somiandras/midi-merger/README.md

# Midi Merge Box

My embedded 🦀 Rust learning project: 2 in, 5 out MIDI merge box based
on a Raspberry Pico board.
