somiandras/midi-merger/hardware/hestore_shopping_list.txt

100.298.79	2	6N138 optocoupler (U1,U2)
100.215.82	1	74HCT14 DIP-14 (U3)
100.230.64	2	1N4148 DO-35 (D1,D2)
100.423.05	7	PJ-3136-B 3.5mm jack (J1,J2,J5-J9)
100.241.52	2	ZL305-20SG 1x20 socket 2.54mm for Pico (J3,J4)
100.231.32	2	DIL08 IC socket (U1,U2)
100.231.33	1	DIL14 IC socket (U3)
100.240.31	14	220R 1% 0.4W metal film (R1,R2,R5,R6,R11-R20)
100.243.86	2	1K 1% 0.4W metal film (R7,R8)
100.243.92	2	2K 1% 0.4W metal film (R9,R10)
100.244.02	2	5.1K 1% 0.4W metal film (R3,R4)
100.234.72	3	100nF 50V X7R RM2.5 (C1,C2,C3)
100.251.22	1	10uF 50V electrolytic 5x11 RM2 (C4)
