somiandras/midi-merger/hardware/MIDI Box.csv

# | Reference | Qty | Value | Footprint | DNP
1 | C1, C2, C3 | 3 | 0.1uF | Capacitor_THT:C_Disc_D3.4mm_W2.1mm_P2.50mm
2 | C4 | 1 | 10uF | Capacitor_THT:CP_Radial_D5.0mm_P2.00mm
3 | D1, D2 | 2 | 1N4148 | Diode_THT:D_T-1_P5.08mm_Horizontal
4 | J1 | 1 | MIDI_IN_1 | own_components:Audio Jack PJ-3136-B
5 | J2 | 1 | MIDI_IN_2 | own_components:Audio Jack PJ-3136-B
6 | J3, J4 | 2 | Conn_01x20_Socket | Connector_PinSocket_2.54mm:PinSocket_1x20_P2.54mm_Vertical
7 | J5 | 1 | MIDI_OUT_1 | own_components:Audio Jack PJ-3136-B
8 | J6 | 1 | MIDI_OUT_2 | own_components:Audio Jack PJ-3136-B
9 | J7 | 1 | MIDI_OUT_3 | own_components:Audio Jack PJ-3136-B
10 | J8 | 1 | MIDI_OUT_4 | own_components:Audio Jack PJ-3136-B
11 | J9 | 1 | MIDI_OUT_5 | own_components:Audio Jack PJ-3136-B
12 | R1, R2, R5, R6, R11, R12, R13, R14, R15, R16, R17, R18, R19, R20 | 14 | 220 | Resistor_THT:R_Axial_DIN0204_L3.6mm_D1.6mm_P5.08mm_Horizontal
13 | R3, R4 | 2 | 5.1K | Resistor_THT:R_Axial_DIN0204_L3.6mm_D1.6mm_P5.08mm_Horizontal
14 | R7, R8 | 2 | 1k | Resistor_THT:R_Axial_DIN0204_L3.6mm_D1.6mm_P5.08mm_Horizontal
15 | R9, R10 | 2 | 2k | Resistor_THT:R_Axial_DIN0204_L3.6mm_D1.6mm_P5.08mm_Horizontal
16 | U1, U2 | 2 | 6N138 | Package_DIP:DIP-8_W7.62mm_Socket
17 | U3 | 1 | 74HCT14 | Package_DIP:DIP-14_W7.62mm_Socket
