somiandras/midi-merger/hardware/MIDI Box.kicad_pcb

## KiCad design hardware/MIDI Box.kicad_pcb (2026-11-06)

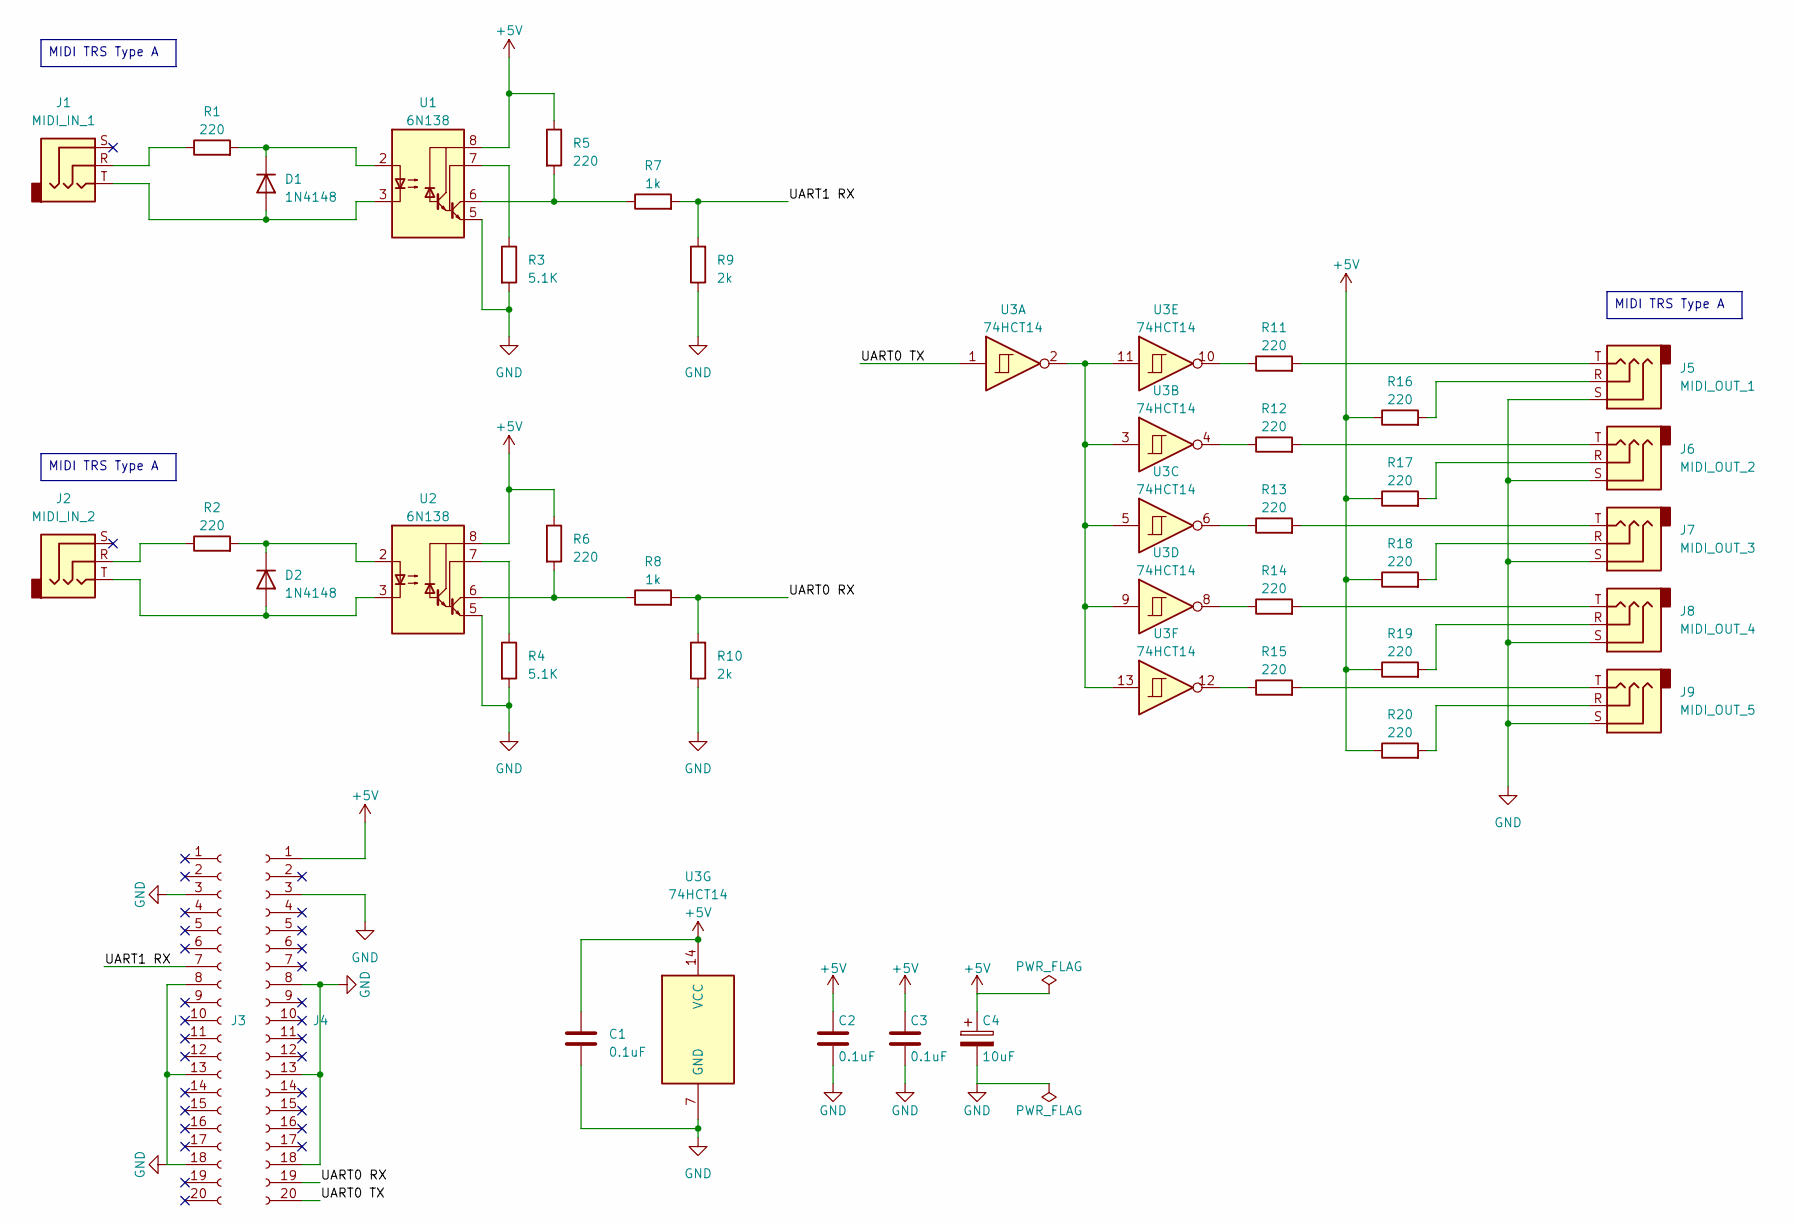
[picture p1: schematic MIDI Box.kicad_sch, Midi Merge Box]

Parts:
C1, C2, C3: 0.1uF; C_Disc_D3.4mm_W2.1mm_P2.50mm
C4: 10uF; CP_Radial_D5.0mm_P2.00mm
D1, D2: 1N4148; D_T-1_P5.08mm_Horizontal
J1: MIDI_IN_1; Audio Jack PJ-3136-B
J2: MIDI_IN_2; Audio Jack PJ-3136-B
J3, J4: Conn_01x20_Socket; PinSocket_1x20_P2.54mm_Vertical
J5: MIDI_OUT_1; Audio Jack PJ-3136-B
J6: MIDI_OUT_2; Audio Jack PJ-3136-B
J7: MIDI_OUT_3; Audio Jack PJ-3136-B
J8: MIDI_OUT_4; Audio Jack PJ-3136-B
J9: MIDI_OUT_5; Audio Jack PJ-3136-B
R1, R2, R5, R6, R11, R12, R13, R14, R15, R16, R17, R18, R19, R20: 220; R_Axial_DIN0204_L3.6mm_D1.6mm_P5.08mm_Horizontal
R3, R4: 5.1K; R_Axial_DIN0204_L3.6mm_D1.6mm_P5.08mm_Horizontal
R7, R8: 1k; R_Axial_DIN0204_L3.6mm_D1.6mm_P5.08mm_Horizontal
R9, R10: 2k; R_Axial_DIN0204_L3.6mm_D1.6mm_P5.08mm_Horizontal
U1, U2: 6N138; DIP-8_W7.62mm_Socket
U3: 74HCT14; DIP-14_W7.62mm_Socket

Connections:
+5V: C1.1, C2.1, C3.1, C4.1, J4.1, R5.1, R6.1, R16.1, R17.1, R18.1, R19.1, R20.1, U1.8 (VCC), U2.8 (VCC), U3.14 (VCC)
/UART0 RX: J4.19, R8.2, R10.2
/UART0 TX: J4.20, U3.1
/UART1 RX: J3.7, R7.2, R9.2
GND: C1.2, C2.2, C3.2, C4.2, J3.3, J3.8, J3.13, J3.18, J4.3, J4.8, J4.13, J4.18, J5.S, J6.S, J7.S, J8.S, J9.S, R3.2, R4.2, R9.1, R10.1, U1.5 (GND), U2.5 (GND), U3.7 (GND)
unnamed: D1.2 (A), J1.T, U1.3 (C2)
unnamed: D1.1 (K), R1.2, U1.2 (C1)
unnamed: D2.2 (A), J2.T, U2.3 (C2)
unnamed: D2.1 (K), R2.2, U2.2 (C1)
unnamed: J1.R, R1.1
unnamed: J2.R, R2.1
unnamed: J5.R, R16.2
unnamed: J5.T, R11.2
unnamed: J6.R, R17.2
unnamed: J6.T, R12.2
unnamed: J7.R, R18.2
unnamed: J7.T, R13.2
unnamed: J8.R, R19.2
unnamed: J8.T, R14.2
unnamed: J9.R, R20.2
unnamed: J9.T, R15.2
unnamed: R11.1, U3.10
unnamed: R12.1, U3.4
unnamed: R13.1, U3.6
unnamed: R14.1, U3.8
unnamed: R15.1, U3.12
unnamed: R3.1, U1.7 (VO1)
unnamed: R5.2, R7.1, U1.6 (VO2)
unnamed: R4.1, U2.7 (VO1)
unnamed: R6.2, R8.1, U2.6 (VO2)
unnamed: U3.2, U3.3, U3.5, U3.9, U3.11, U3.13

Notes on the sheet:
MIDI TRS Type A

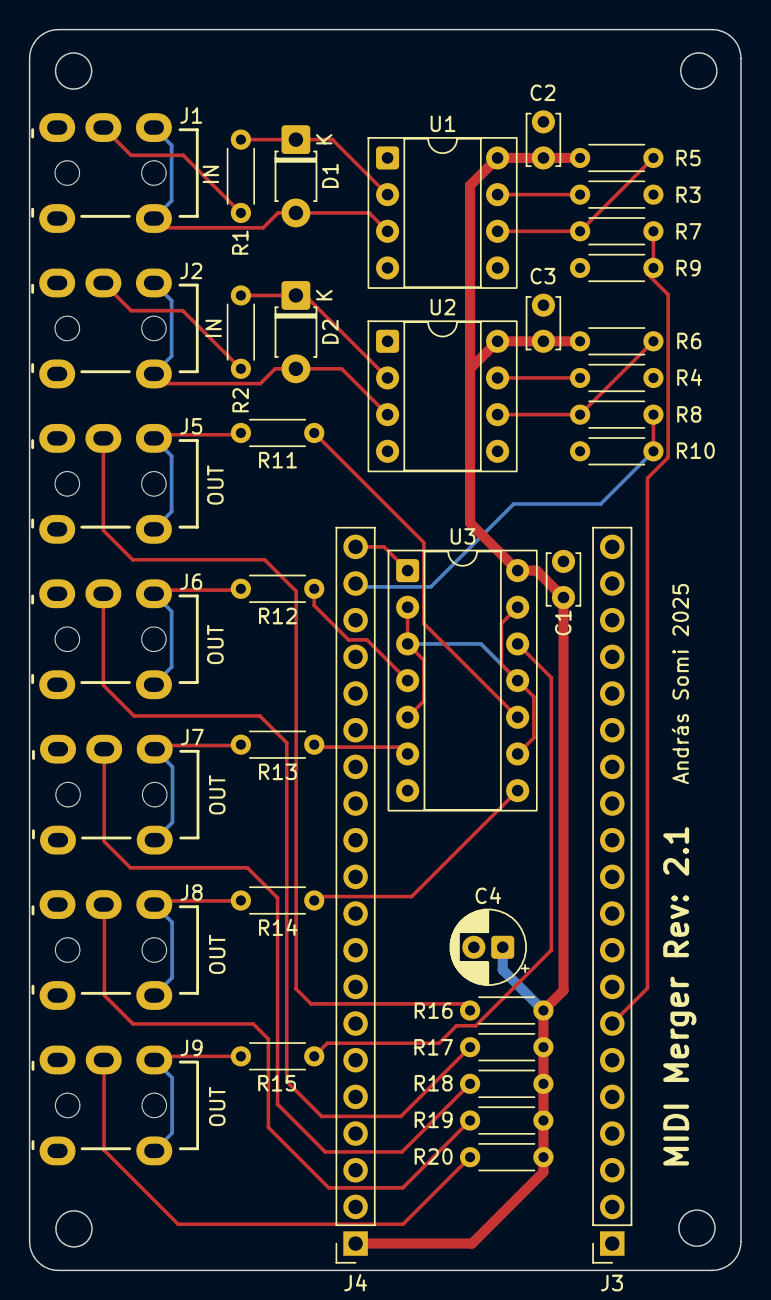
[picture p2: board MIDI Box.kicad_pcb from above]

Board: 2 copper layers, 49.3 x 85.9 mm, 38 parts (0 on the bottom side), 31 nets.
