somiandras/midi-merger/(commit log)

2025-01-06 fix uart pin
2025-01-06 add midi uart srtuct
2025-01-06 add uart write
2025-01-06 add hardware related files
    [MIDI Box-B_Cu.gbl, MIDI Box-B_Mask.gbs, MIDI Box-B_Paste.gbp, MIDI Box-B_Silkscreen.gbo, MIDI Box-Edge_Cuts.gm1, MIDI Box-F_Cu.gtl, MIDI Box-F_Mask.gts, MIDI Box-F_Paste.gtp]
2025-01-12 remove fab related artifacts
    [MIDI Box-B_Cu.gbl, MIDI Box-B_Mask.gbs, MIDI Box-B_Paste.gbp, MIDI Box-B_Silkscreen.gbo, MIDI Box-Edge_Cuts.gm1, MIDI Box-F_Cu.gtl, MIDI Box-F_Mask.gts, MIDI Box-F_Paste.gtp]
2025-02-13 v2.0 board with TRS sockets
    [MIDI Box.kicad_pcb, MIDI Box.kicad_sch]
2025-02-16 fix running status errors
    [main.rs, midi_parser.rs, midi_uart.rs]
2025-10-02 fix: replace unwrap() with proper error handling in write path
    Eliminates all panic risks in the UART write task by replacing unwrap()
    calls with explicit error handling. UART write failures now log errors
    and skip the problematic message instead of crashing the system.
    Changes:
    - Voice messages: handle write errors gracefully
    - System messages: handle write errors gracefully
    - Running status: comprehensive rewrite with proper error handling
    - Handles first-message edge case (last_tx_from = None)
    - Eliminates double unwrap() on status byte retrieval
    - Detects protocol violations (running status without prior voice)
    - Uses continue to prevent state corruption on failures
    All error p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
    [main.rs]
2025-10-02 feat: add graceful SysEx handling and fix defmt formatting
    Add System Exclusive (SysEx) message handling to MIDI parser. SysEx
    messages (0xF0...0xF7) are now silently ignored and don't corrupt
    parser state, making them transparent to the merge operation.
    Changes to midi_parser.rs:
    - Add in_sysex boolean field to MidiParser
    - Detect SysEx start (0xF0) and end (0xF7) bytes
    - Ignore all data bytes while inside SysEx message
    - System Realtime messages can still interrupt SysEx (per MIDI spec)
    - Clear parser state on SysEx start/end
    Changes to main.rs:
    - Remove error detail from defmt::error!() messages (embassy_rp::uart::Error
    doesn't implement defmt::Format trait)
    - Error messages still pro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
    [main.rs, midi_parser.rs]
2025-10-02 perf: increase channel capacity from 10 to 64 messages
    Improve buffering tolerance for burst MIDI traffic by increasing the
    message channel capacity from 10 to 64 messages.
    At full MIDI bandwidth (~1000 messages/sec), this provides:
    - Before: 10ms of buffering (prone to overflow during jitter)
    - After: 64ms of buffering (better tolerance for write task delays)
    The memory overhead is minimal since UartMidiMessage is small, and the
    improved reliability is worth the tiny cost in an embedded context.
    Fixes issue #5 from CODE_REVIEW_ISSUES.md
    [main.rs]
2025-10-02 refactor: improve UART error handling and code clarity
    Improve error handling in UART read loop with specific handling for
    overrun errors. Refactor control flow for better readability.
    - Add explicit handling for UART overrun errors with warning log
    - Replace labeled break with direct return statements (clearer flow)
    - Simplify match patterns (Ok(Some), Ok(None) instead of nested if-let)
    - Update comment about single-byte reads and future optimization path
    Note: Issue #6 (single-byte UART reads performance) cannot be fully
    addressed without upgrading Embassy to a version with read_until_idle()
    support. This would require embassy-rp 0.3+ which has breaking changes
    and dependency co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
    [midi_uart.rs]
2025-10-02 perf: migrate to BufferedUart for efficient interrupt-driven I/O
    Replace DMA-based single-byte UART reads with BufferedUart's interrupt-
    driven buffering approach. This provides significant performance improvements
    for MIDI's bursty byte-stream traffic pattern.
    Performance improvements:
    - Reduce context switches from ~3,125/sec to ~100-300/sec (10-30x reduction)
    - Interrupt handler fills buffers in background, reducing CPU overhead
    - fill_buf()/consume() pattern processes multiple bytes per call
    - Better resilience to burst MIDI traffic and overrun conditions
    Memory usage:
    - 3 static buffers × 256 bytes = 768 bytes total (0.3% of 264KB RAM)
    - Provides ~82ms of buffering at max MIDI throug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
    [main.rs, midi_parser.rs, midi_uart.rs]
2025-10-03 refactor: use addr_of_mut!() and is_err() for better Rust idioms
    - Replace direct mutable static references with core::ptr::addr_of_mut!()
    - Replace redundant pattern matching with is_err() method calls
    [main.rs]
2025-10-03 fix: remove undefined MIDI status bytes from SystemCommon range
    Removed reserved/undefined bytes (0xF9-0xFC) from SystemCommon validation
    to comply with MIDI 1.0 specification. Now only accepts valid SystemCommon
    messages: 0xF1 (MTC Quarter Frame), 0xF2 (Song Position), 0xF3 (Song
    Select), and 0xF6 (Tune Request).
    Addresses code review issue #7.
    [midi_parser.rs]
2025-10-03 refactor: eliminate code duplication in Format implementation
    Consolidated four identical match arms into a single pattern using
    or-patterns. All MidiMessage variants now share the same formatting
    logic, reducing maintenance burden and improving code clarity.
    Addresses code review issue #9.
    [midi_parser.rs]
2025-10-03 refactor: pass u8 by value instead of reference in feed_byte
    Changed feed_byte signature from `&byte: &u8` to `byte: u8` since u8
    is Copy and should be passed by value. Updated call site to dereference
    the byte from the buffer iterator.
    Addresses code review issue #12.
    [midi_parser.rs, midi_uart.rs]
2025-10-03 refactor: replace unwrap() with expect() for task spawn errors
    Added descriptive error messages to task spawn calls using expect()
    instead of unwrap(). While these errors are still fatal during
    initialization (as they should be), the error messages now clearly
    indicate which task failed to spawn for easier debugging.
    Addresses code review issue #8.
    [main.rs]
2025-10-03 refactor: rename build_release.sh to flash_release.sh
    The script uses 'cargo run' which builds AND flashes to the device via
    probe-rs (configured as the runner in .cargo/config.toml). Renamed to
    accurately reflect that it performs a flash operation, not just a build.
    Addresses code review issue #13.
2025-10-03 perf: add release profile optimization for embedded systems
    Added [profile.release] section with embedded-optimized settings:
    - opt-level = "z": Optimize for binary size (critical for flash-constrained devices)
    - lto = true: Enable link-time optimization for better code generation
    - codegen-units = 1: Single codegen unit for maximum optimization
    - debug = true: Preserve debug symbols for probe-rs debugging
    These settings prioritize flash usage over compile time, which is
    appropriate for embedded targets with limited storage.
    Addresses code review issue #14.
2025-10-03 docs: add API documentation for public MIDI parser types
    Added comprehensive doc comments for:
    - MidiMessage enum: Explains the four message categories and data format
    - MidiMessageError enum: Documents each error variant's meaning
    - MidiParser struct: Describes parser functionality and usage
    This completes API documentation for all public types and functions,
    improving code discoverability and developer experience.
    Addresses code review issue #10.
    [midi_parser.rs]
2025-10-04 fix: reset parser state on protocol errors
    Add self.clear() calls before returning DuplicateStatus and
    UnexpectedDataByte errors. Without state reset, the parser
    remains in a corrupt state after protocol violations, causing
    subsequent valid status bytes to be misinterpreted as data
    bytes (and vice versa).
    This fix ensures the parser can resynchronize on the next
    valid status byte after encountering errors.
    Resolves Issue 1 from midi_parser_improvements.md
    [midi_parser.rs]
2025-10-04 feat: add MIDI byte validation for corrupted data detection
    Add validation to reject invalid and undefined MIDI bytes, preventing
    parser desynchronization from electrical noise or transmission errors.
    - Add InvalidStatusByte error variant for undefined MIDI bytes
    - Validate undefined status bytes (0xF4, 0xF5, 0xF9-0xFD)
    - Validate undefined SystemRealtime bytes (0xF9, 0xFD)
    - Add error logging for validation failures
    The if/else control flow already ensures data bytes have bit 7 clear,
    so no separate InvalidDataByte check is needed - corrupted data bytes
    with bit 7 set are caught as invalid status bytes.
    Implements Issue 2 from midi_parser_improvements.md. Complies with
    MIDI 1.0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
    [main.rs, midi_parser.rs]
2025-10-04 feat: add 300ms timeout for incomplete MIDI messages
    Implements Issue 3 from midi_parser_improvements.md with inline timeout
    approach. Parser now detects and recovers from incomplete messages caused
    by cable disconnects, electrical noise, or hardware glitches.
    - Add last_byte_time field to track message completion timing
    - Add MIDI_BYTE_TIMEOUT_MS constant (300ms) with documentation
    - Check timeout before processing each byte (except SystemRealtime)
    - SystemRealtime messages (0xF8-0xFF) don't update timestamp by design
    - Clear parser state on timeout to allow resynchronization
    The 300ms timeout is generous (actual transmission <1ms) to allow for
    device processing delays while prev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
    [midi_parser.rs]
2025-10-04 feat: invalidate running status on parser errors
    Implements Issue 4: Running Status Invalidation on Errors
    - Add ControlMessage system for invalidating running status tracking
    - ChannelMessage enum wraps both MIDI data and control commands
    - write_uart task handles InvalidateRunningStatus control messages
    - read_from_uart sends invalidation on both UartError and MessageError
    - Parser now resets on MessageError (previously only on UartError)
    - Add Debug derive to UartMidiMessage for ChannelMessage::Debug
    This prevents stale running status injection when a parser error occurs.
    Without this fix, cached status bytes could be injected after parser
    reset, causing incorrect MIDI messages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
    [main.rs, midi_uart.rs]
2025-10-04 feat: add resynchronization mode after parser errors
    Implements Issue 5: No Resynchronization Mode
    - Add ParserState enum with Reading, Resyncing, and InSysEx variants
    - Replace in_sysex and resyncing booleans with single state field
    - Refactor feed_byte() to use pattern matching on state
    - All error paths now enter Resyncing mode
    - Parser hunts for next valid status byte during resync
    - Discards garbage bytes until synchronization restored
    - Reorder timeout check before state machine to fix control flow
    State machine behavior:
    - Reading: Normal message parsing
    - Resyncing: Discards data bytes, validates status bytes
    - InSysEx: Discards all bytes until 0xF7
    This prevents cascadin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
    [midi_parser.rs]
2025-10-04 feat: add diagnostic buffer for MIDI parser debugging
    Add a circular buffer that stores the last 32 bytes received by the
    parser to aid in debugging parser errors. The buffer:
    - Uses sequence numbers for chronological ordering
    - Logs automatically when any parser error occurs
    - Is conditionally compiled (debug builds only)
    - Zero-cost in release builds (no-op ZST implementation)
    - Optimized to avoid stack allocation during logging
    This helps diagnose what byte sequence led to parser errors like
    invalid status bytes, duplicate status, unexpected data bytes, and
    message timeouts.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
    [midi_parser.rs]
2026-11-05 chore: upgrade hardware project files to KiCad 10
    Files re-saved by KiCad 10: board, project and local settings use the new file format versions, and the footprint info cache was regenerated. No intended design changes.
2026-11-05 chore: add Konnect KiCad MCP server, skills and agents
    Project-scoped setup for the Konnect MCP server (v0.13.0):
    - .mcp.json registers the konnect server
    - .claude/skills: konnect, kicad-schematic, kicad-pcb, kicad-review, kicad-library, kicad-manufacture
    - .claude/agents: kicad-design-review-agent, kicad-schematic-build-agent
    - .claude/settings.json: PreToolUse hooks Konnect uses to guard PCB tools
    Changes from the upstream konnect init output: agents get Read, Glob and WebFetch so they can read reference files and datasheets; consistent decoupling and power-connection guidance; corrected IPC API, rotation and crystal/LED guidance; reliability contract trimmed to the caller rules; review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
2026-11-05 [0j08] Use GP16/GP17 for UART0 to match the board
    The board wires UART0 TX/RX to Pico GP16/GP17 (J4 pins 20/19); the firmware used GP12/GP13, which are unconnected. Comments now match the schematic: J1 (MIDI IN 1) is on UART1, J2 (MIDI IN 2) on UART0.
2026-11-05 [yd73] Docs: the box has 5 MIDI outputs
    The board has five output jacks (J5-J9).
2026-11-05 [pbeg] Schematic: 74HCT14 buffer, opto decoupling, Pico GNDs, ERC clean
    U3: CD40106 replaced by 74HCT14 (same pinout). Its TTL input threshold works with the Pico's 3.3 V output at 5 V supply, and it drives the 5 MIDI output loops much harder than a 4000-series part.
    C2/C3: 100 nF on the 6N138 (U1/U2) supply. C4: 10 uF bulk on +5V.
    Pico GND pins J3-3/8/13/18 and J4-8/13/18 now tied to GND (J4-3 already was).
    ERC cleanup: no-connect flags on unused Pico pins and MIDI IN sleeves, PWR_FLAG on +5V and GND, dangling UART RX wire stubs trimmed, U1/U2 symbols refreshed from the library.
    The file was re-saved by kicad-cli sch upgrade (KiCad 8 -> 10 format) to repair empty project names in the inst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
2026-11-05 [rxgk] Place decoupling caps, sync PCB from schematic, clear DRC errors
    PCB synced from schematic (F8): adds C2, C3 (100nF at U1/U2 pin 8) and C4 (10uF bulk on +5V, B.Cu link to R16), U3 value 74HCT14, Pico GND pins J3/J4 3/8/13/18 on GND via the B.Cu pour.
    Removes the J1/J2 sleeve-to-sleeve tracks: the sleeve pins are no-connect on MIDI inputs, so KiCad gives each pad its own net and the track became a short.
    Refreshes 25 footprints (R1-R20, D1, D2, C1, J3, J4) from the KiCad 10 libraries. Zone refill cleared the copper-to-edge error at the bottom-left mounting hole.
    DRC: 0 errors, 0 unconnected; 11 warnings remain (U1-U3 library mismatch, new cap reference text overlapping silk). File r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
2026-11-05 [pcnj] Refresh U1-U3 footprints from library, clear silk overlaps
    U1/U2/U3 updated from Package_DIP in KiCad (Konnect cannot copy their footprint losslessly). C2/C3/C4 reference text moved off neighbouring outlines and pads. DRC: 0 errors, 0 warnings, 0 unconnected.
2026-11-05 [6hz3] Add hestore shopping list for design-review BOM
    Tab-separated basket import file for hestore.hu (code, quantity, name), built from the fix/design-review schematic BOM: adds C2, C3, C4 and the 74HCT14. Resistors are the 0.4W metal film series (1.9x3.7mm body) to fit the DIN0204 5.08mm footprint. Raspberry Pi Pico is not included.
2026-11-05 [ntqp] Stop tracking KiCad backup and cache files
    The gitignore patterns did not match MIDI Box.kicad_sch-bak or fp-info-cache. Fix the patterns, ignore KiCad's *-backups/ folder, and untrack both files.
2026-11-05 [ntqp] Untrack KiCad schematic backup and footprint cache
2026-11-06 [9aze] Bump board to rev 2.1, regenerate BOM files
    Rev 2.0 boards have no C2-C4 footprints, so the changed board gets 2.1 on the silkscreen and schematic title block. MIDI Box.csv/.xml were left over from rev 1; regenerated from the current schematic with kicad-cli. Schematic re-saved by eeschema (formatting only).
    kicad-cli: ERC 0 violations; DRC 0 violations, 0 unconnected, 0 schematic parity issues.
2026-11-06 [jesk] Skip Rust pre-commit checks for non-software commits
    Track the pre-commit hook in .githooks and document enabling it with git config core.hooksPath. The hook exits early when no staged path is under software/, so hardware and docs commits no longer compile the firmware dependency tree. Software commits still run cargo fmt --check and cargo clippy with -D warnings. The hook lives in .githooks rather than scripts/ because .gitignore ignores every scripts/ directory.
2026-11-06 [ecn9] Enable konnect MCP server in project settings
    Adds enabledMcpjsonServers with konnect to the tracked .claude/settings.local.json so every clone and worktree loads the KiCad MCP server defined in .mcp.json. Also adds the missing final newline.
2026-11-06 [1fvg] Gitignore .claude/worktrees in main checkout
    Worktrees live under .claude/worktrees/ and showed as untracked in the main checkout; git add -A there would stage them as embedded repos, and rg/editors searched every copy. Only the worktrees folder is ignored because .claude/settings.json is tracked.
